ToffePeer1/schuwe-lichten/docs/images/uitleg.png

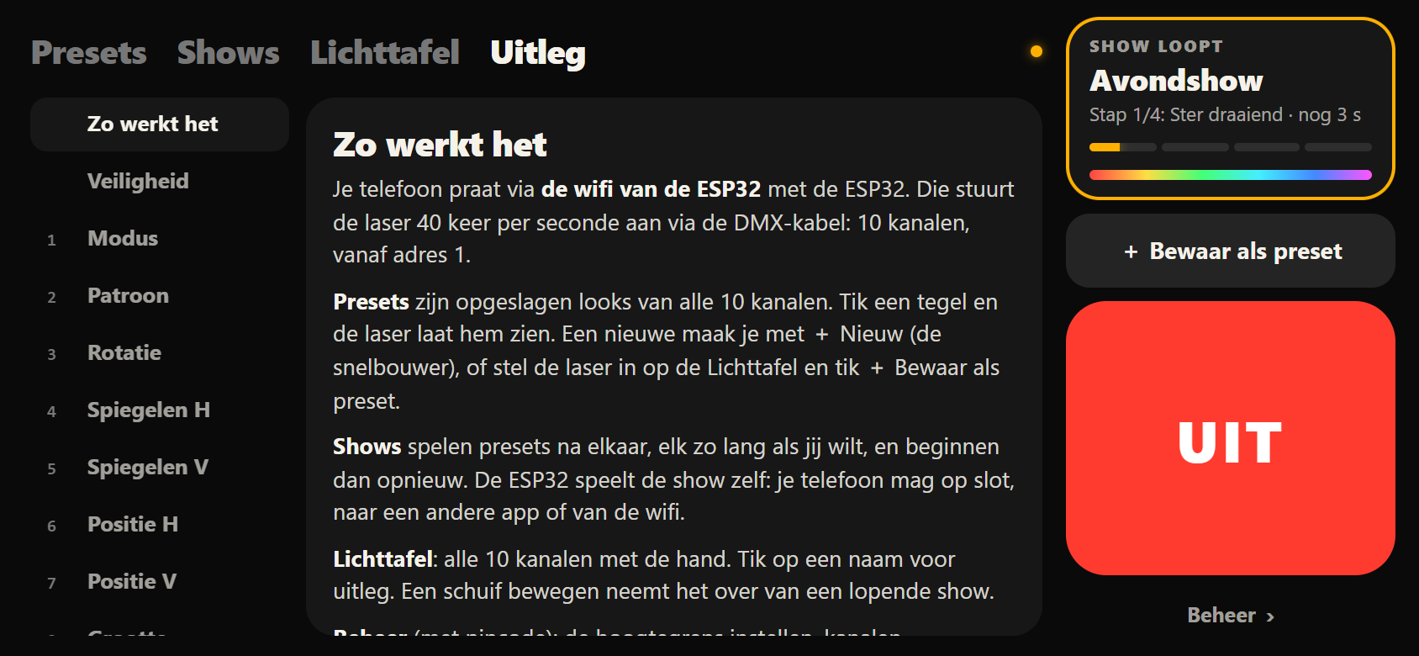
docs/images/uitleg.png
