ToffePeer1/schuwe-lichten/enclosure/laser_controller_case.3mf

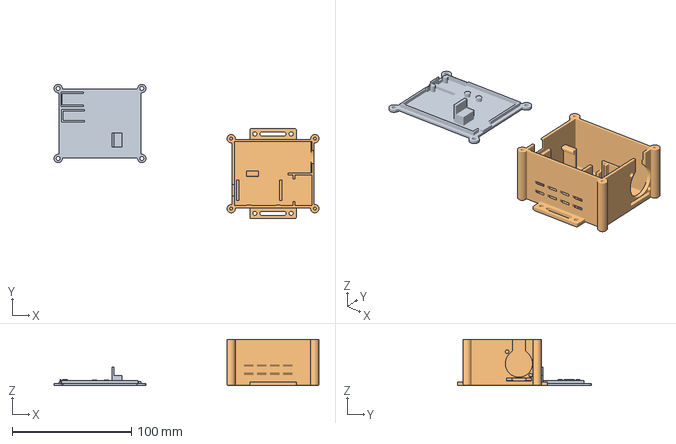
[picture p7: CAD file, 2026-11-12]
enclosure/laser_controller_case.3mf
222.3 x 112.7 x 39.0 mm
lid.stl
base.stl
