ToffePeer1/schuwe-lichten/enclosure/coupon.stl

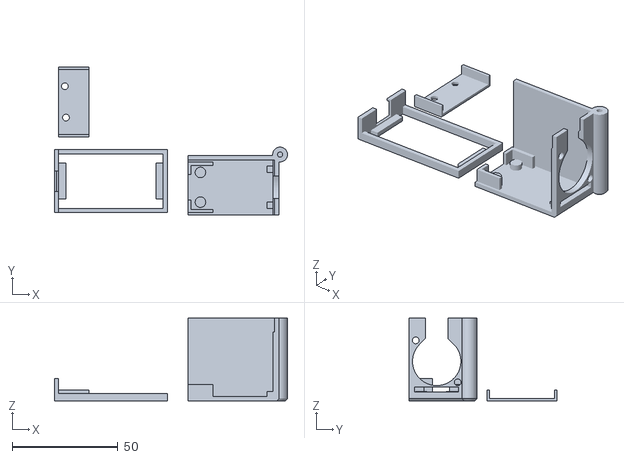
[picture p8: CAD file, 2026-11-12]
enclosure/coupon.stl
110.0 x 69.9 x 39.0
