ToffePeer1/schuwe-lichten/enclosure/lid.stl

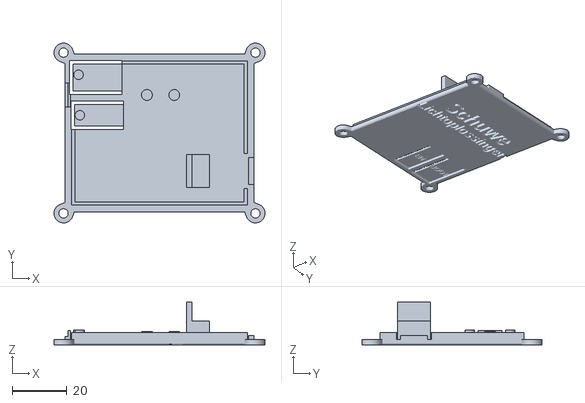
[picture p9: CAD file, 2026-11-12]
enclosure/lid.stl
77.1 x 65.7 x 15.6
