ToffePeer1/schuwe-lichten/enclosure/base.stl

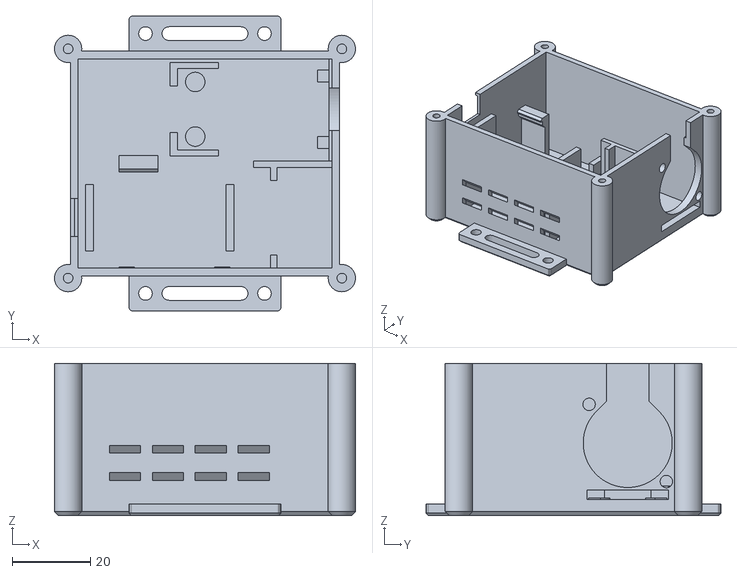
[picture p10: CAD file, 2026-11-12]
enclosure/base.stl
77.1 x 75.6 x 39.0
