ToffePeer1/schuwe-lichten/src/settings_store.h

#pragma once

#include "settings_blob.h"

// Persists laser::Settings as one CRC-checked NVS blob (atomic per entry).
namespace settings_store {

struct LoadResult {
  laser::Settings settings;
  bool wasMissing;  // first boot: defaults, nothing saved yet
  bool wasReset;    // a blob existed but was invalid: defaults loaded instead
};

LoadResult load(const char* factoryPin, uint16_t defaultAddress);

// Writes the blob, reads it back and compares. False if anything went wrong.
bool save(const laser::Settings& settings);

}  // namespace settings_store
