ToffePeer1/schuwe-lichten/(commit log)

2026-10-21 build: Add PlatformIO config for ESP32 dev board
2026-10-21 feat: Add laser safety core with unit tests
2026-11-12 feat: Add calibrated limits, presets, shows and IO0 stop to firmware
2026-11-12 feat: Add printable enclosure for ESP32 and VMA432
    [base.stl, coupon.stl, enclosure.scad, laser_controller_case.3mf, lid.stl]
2026-11-12 docs: Update README for calibration, presets and shows
2026-11-12 fix: Drop the old WiFi name and stage labels from pages and banner
    [main.cpp]
2026-11-12 docs: Add safety and protocol docs and point code comments at them
    [enclosure.scad]
2026-11-12 docs: Add hand-traced pattern data behind the page drawings
2026-11-12 docs: Rewrite README with hardware, laser findings and screenshots
